dewsl/sensors/calibrationxadis/Calibration.brd

## EAGLE design calibrationxadis/Calibration.brd (2022-03-29)

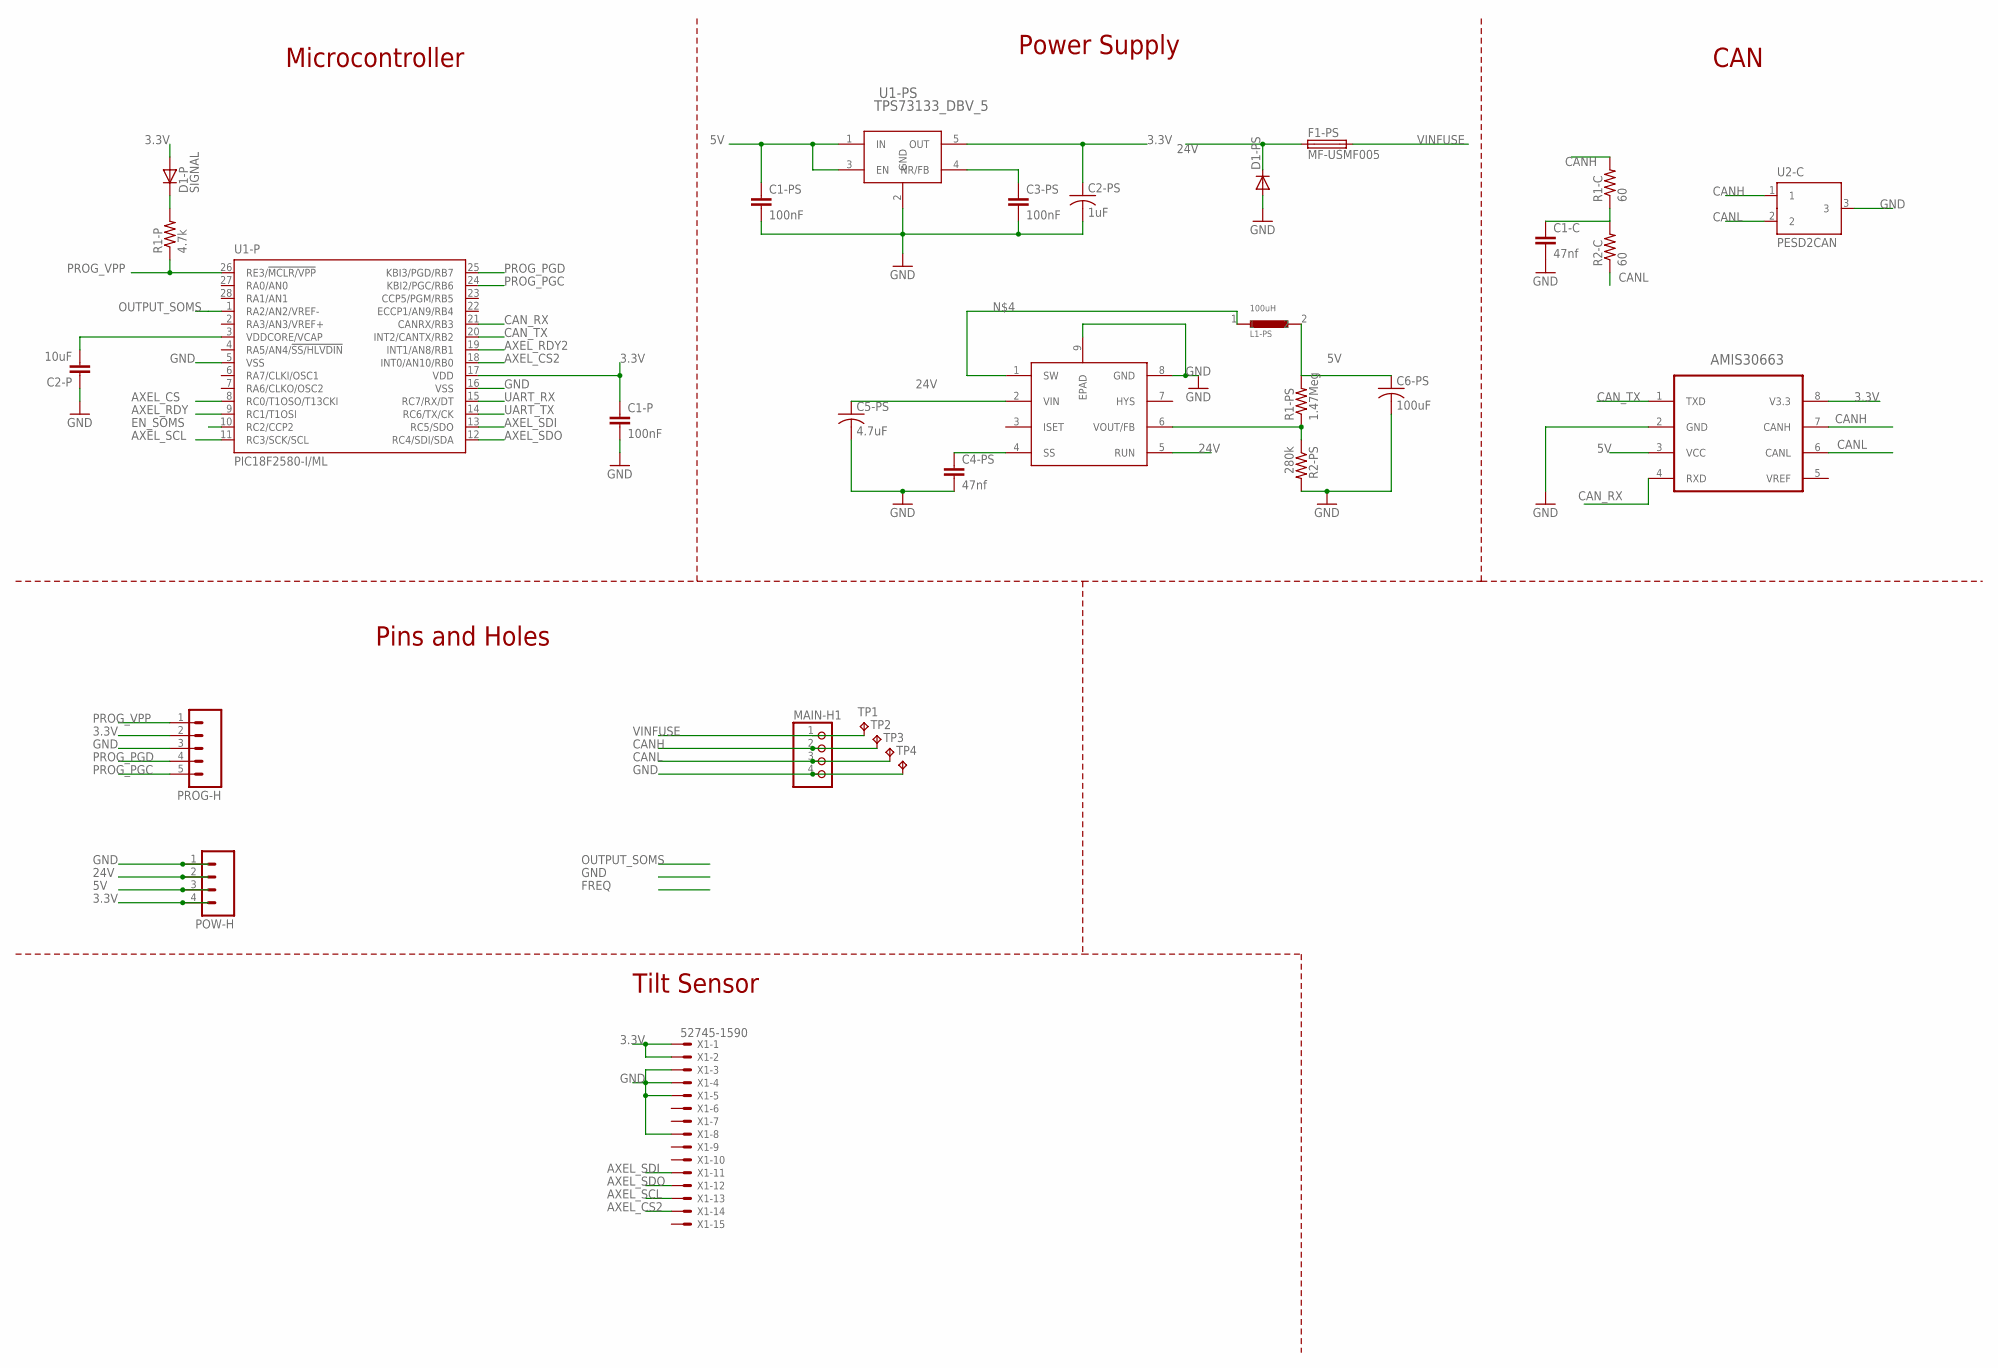
[picture p9: schematic Calibration.sch]

Parts:
C1-C, C4-PS: 47nf; C0805
C1-P, C1-PS, C3-PS: 100nF; C0603
C2-P: 10uF; C0603
C2-PS: 1uF; C0402
C5-PS: 4.7uF; C1206K
C6-PS: 100uF; C1210K
D1-P: SIGNAL; DIODE-0603
D1-PS: DIODE-DO-214AC; DO-214AC
F1-PS: MF-USMF005; 1210
L1-PS: 100uH; 1210
MAIN-H1: PINHD-1X04_2.54; 1X04
POW-H: M041X04_NO_SILK; 1X04_NO_SILK
PROG-H: M05PTH; 1X05
R1-C, R2-C: 60; R0805
R1-P: 4.7k; R0603
R1-PS: 1.47Meg; R0805
R2-PS: 280k; R0805
TP1, TP2, TP3, TP4: TPTP10SQ; TP10SQ
U1-P: PIC18F2580-I/ML; QFN28-ML_6X6MM
U1-PS: TPS73133_DBV_5; DBV5
U2: AMIS30663CAN; SOIC8
U2-C: PESD2CAN; SOT23
U2-PS: LTC3631-5; MSOP8E
X1: 52745-1590

Connections:
3.3V: C1-P.1, C2-PS.1, D1-P.A, POW-H.4, PROG-H.2, U1-P.17 (VDD), U1-PS.5 (OUT), U2.8 (V3.3), X1.1, X1.2
5V: C1-PS.1, C6-PS.1, L1-PS.2, POW-H.3, R1-PS.2, U1-PS.1 (IN), U1-PS.3 (EN), U2.3 (VCC)
24V: C5-PS.1, D1-PS.1 (C), F1-PS.1, POW-H.2, U2-PS.2 (VIN), U2-PS.5 (RUN)
AXEL_CS: U1-P.8 (RC0/T1OSO/T13CKI)
AXEL_CS2: U1-P.18 (INT0/AN10/RB0), X1.14
AXEL_RDY: U1-P.9 (RC1/T1OSI)
AXEL_RDY2: U1-P.19 (INT1/AN8/RB1)
AXEL_SCL: U1-P.11 (RC3/SCK/SCL), X1.13
AXEL_SDI: U1-P.13 (RC5/SDO), X1.11
AXEL_SDO: U1-P.12 (RC4/SDI/SDA), X1.12
CANH: MAIN-H1.2, R1-C.2, TP2.TP, U2.7 (CANH), U2-C.1
CANL: MAIN-H1.3, R2-C.1, TP3.TP, U2.6 (CANL), U2-C.2
CAN_RX: U1-P.21 (CANRX/RB3), U2.4 (RXD)
CAN_TX: U1-P.20 (INT2/CANTX/RB2), U2.1 (TXD)
EN_SOMS: U1-P.10 (RC2/CCP2)
GND: C1-C.2, C1-P.2, C1-PS.2, C2-P.1, C2-PS.2, C3-PS.2, C4-PS.2, C5-PS.2, C6-PS.2, D1-PS.2 (A), MAIN-H1.4, POW-H.1, PROG-H.3, R2-PS.2, TP4.TP, U1-P.5 (VSS), U1-P.16 (VSS), U1-PS.2 (GND), U2.2 (GND), U2-C.3, U2-PS.8 (GND), U2-PS.9 (EPAD), X1.3, X1.4, X1.5, X1.8
unnamed: C1-C.1, R1-C.1, R2-C.2
unnamed: L1-PS.1, U2-PS.1 (SW)
unnamed: C3-PS.1, U1-PS.4 (NR/FB)
unnamed: R1-PS.1, R2-PS.1, U2-PS.6 (VOUT/FB)
unnamed: D1-P.C, R1-P.2
unnamed: C4-PS.1, U2-PS.4 (SS)
unnamed: C2-P.2, U1-P.3 (VDDCORE/VCAP)
OUTPUT_SOMS: U1-P.1 (RA2/AN2/VREF-)
PROG_PGC: PROG-H.5, U1-P.24 (KBI2/PGC/RB6)
PROG_PGD: PROG-H.4, U1-P.25 (KBI3/PGD/RB7)
PROG_VPP: PROG-H.1, R1-P.1, U1-P.26 (RE3/!MCLR/VPP)
UART_RX: U1-P.15 (RC7/RX/DT)
UART_TX: U1-P.14 (RC6/TX/CK)
VINFUSE: F1-PS.2, MAIN-H1.1, TP1.TP

Notes on the sheet:
Microcontroller
Power Supply
CAN
Pins and Holes
Tilt Sensor

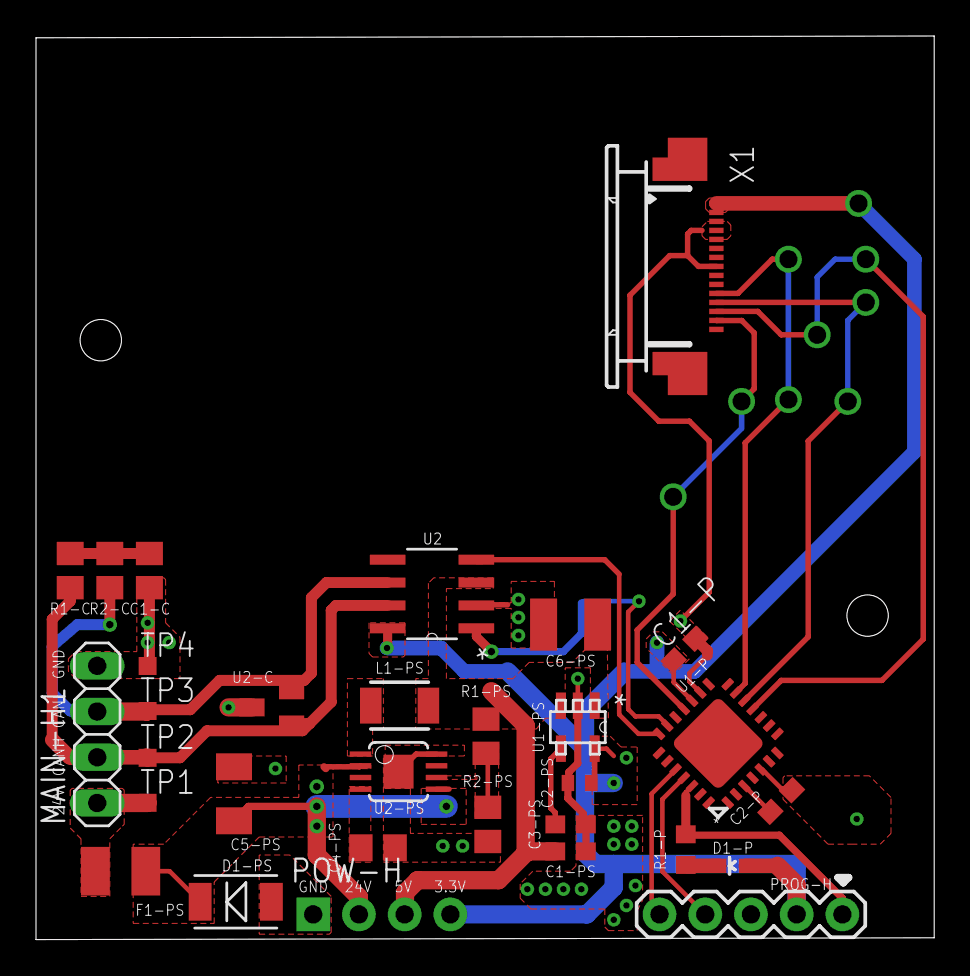
[picture p10: board Calibration.brd from above]

Board: 2 copper layers, 49.9 x 50.2 mm, 31 parts (0 on the bottom side), 23 nets.
