dewsl/sensors/(commit log)

2018-03-06 added basic teensy can codes.
2018-05-18 Added the pic codes for the v3 sensors that support both v2 and v3 calibration methods.
2020-03-04 update adis code for v5 sensors
2020-08-10 +added surficialtilt arduino code
2021-12-15 add calibration and update sensor codes for version 4&5 sensors
2022-03-29 added adis schematic board
    [Calibration.brd, Calibration.sch]
2025-06-17 updated calibration script
    same file, just cleaned and updated some function. also added print column for failing parameters xyz
    [updated_Ensalada_CALIB.py]
2025-06-18 Update updated_Ensalada_CALIB.py
    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
    [updated_Ensalada_CALIB.py]
